enzopereira1701/wineguard/README.md

<p align="center">
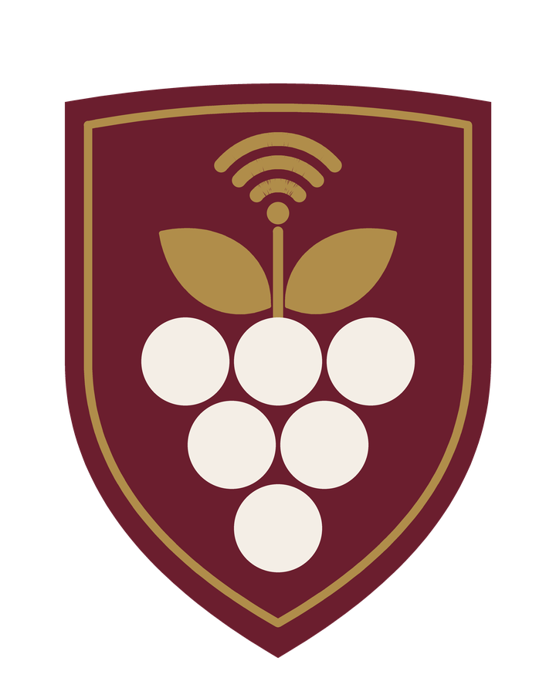
[picture p1: docs/imagens/wineguard-emblema.png]
Emblema do WineGuard
  
</p>

<h1 align="center">WineGuard</h1>
<p align="center"><em>Cada garrafa no ponto certo.</em></p>

Monitoramento de adegas de vinho com **IoT**: um dispositivo com ESP32 vigia temperatura, umidade e luminosidade, avisa na hora por **LED,
buzzer e tela** quando algo sai do ponto, e envia os dados para uma plataforma **FIWARE**. Um **dashboard web** mostra tudo em tempo real,
em gráficos, e deixa cadastrar dispositivos, ajustar os limites e gerenciar várias vinherias.

Projeto do grupo **marcha.dev** para o **CP5 Vinheria Full**. Base: *FIWARE Smart Lamp* e *FIWARE Descomplicado*, do Prof. Fábio H. Cabrini.

## Sumário

1\. [O problema](#o-problema) · 2. [A solução](#a-solução) · 3. [Diferenciais](#diferenciais) · 4. [Status do projeto](#status-do-projeto)  
5\. [Demonstração](#demonstração) · 6. [Arquitetura](#arquitetura) · 7. [Várias vinherias](#várias-vinherias)  
8\. [O Node (hardware)](#o-wineguard-node-hardware) · 9. [Alertas](#como-o-node-avisa) · 10. [Protocolo](#protocolo-mqtt)  
11\. [Plataforma FIWARE](#plataforma-fiware) · 12. [Dashboard](#dashboard) · 13. [Referências de guarda](#referências-de-guarda)  
14\. [Como rodar](#como-rodar) · 15. [Estrutura do repositório](#estrutura-do-repositório) · 16. [Limitações e evolução](#limitações-e-evolução)  
17\. [Créditos](#créditos) · 18. [Equipe](#equipe)  

## O problema

Vinho guardado em condições erradas estraga, e quase sempre ninguém percebe a tempo. Segundo especialistas e fabricantes de adegas:

- **Temperatura:** o calor acelera o envelhecimento. E o que mais prejudica não é só o valor, é a temperatura que sobe e desce.
- **Umidade:** muito baixa resseca as rolhas; muito alta danifica rótulos e caixas.
- **Luz:** luz forte altera a cor e o sabor, principalmente em espumantes e garrafas de vidro claro.

Uma adega comum não avisa ninguém quando isso acontece, e a pessoa só descobre quando o vinho já foi perdido.

## A solução

| Parte | O que é |
|---|---|
| **WineGuard Node** | ESP32 com sensores (DHT22 e LDR) e avisos (LED RGB, buzzer e tela OLED), numa caixa impressa em 3D. Um por adega |
| **Plataforma (FIWARE)** | Recebe as leituras por MQTT, guarda o último valor (Orion) e o histórico (STH-Comet) e leva os comandos de volta ao Node |
| **Backend (FastAPI)** | Confere os limites de cada adega, abre e fecha alertas, cuida de vinherias e da suspensão |
| **Dashboard (React)** | Gráficos em tempo real, cadastro de dispositivos, limites (triggers), histórico de alertas e vinherias |

Se a nuvem cair, o Node **continua alertando** sozinho, com os limites guardados na memória.

## Diferenciais

O que o WineGuard faz além de medir e mostrar (a lista completa, com onde ver e como provar cada ponto, está em [`docs/diferenciais.md`](docs/diferenciais.md)):

1. **Alerta em três canais, com significado:** a cor do LED diz a variável, o som diz o sentido (acima ou abaixo) e a tela mostra o valor e o limite.
2. **Continua protegendo sem a nuvem:** depois de 15 s sem conexão, o Node avalia os limites sozinho.
3. **Várias vinherias isoladas, com suspensão por inadimplência:** os dados não se misturam e o histórico é preservado.
4. **Referências de guarda com fontes e avisos:** presets de guarda (não de servir) e um painel que avisa quando os valores não fazem sentido.
5. **Alerta de estabilidade:** avisa quando a temperatura varia mais de 2 °C em 24 h, mesmo dentro da faixa.

De apoio: ajuste remoto dos limites com confirmação do Node, calibração da luz, cadastro e identificação de Nodes pelo painel, backend em contêiner que volta sozinho com 176 testes, Node físico em caixa 3D testado na nuvem e documentação completa, com as limitações assumidas.

## Status do projeto

Atualizado em 27/10/2026. Este README descreve o que existe e foi testado; o que falta está marcado.

| Parte | Estado |
|---|---|
| Node: hardware, firmware 2.3 e caixa impressa em 3D | **Pronto e testado** na bancada, na nuvem e no Wokwi |
| Plataforma FIWARE na AWS | **Pronta**: dados e histórico chegam, comandos chegam ao Node |
| Cadastro de dispositivo (`provisionar.sh` e pelo dashboard) | **Pronto** |
| Backend (FastAPI) | **Pronto**, rodando em contêiner na instância (porta 8000), com 176 testes automáticos |
| Dashboard (front-end) | **Pronto**, ligado ao backend real e testado no computador e no celular |
| Manuais de instalação e de operação | **Prontos** ([instalação](docs/manual-instalacao.md) e [operação](docs/manual-operacao.md)) |
| Vídeo | **A fazer** |

Provado de ponta a ponta com o Node físico: telemetria, histórico, alertas ALTA e BAIXA, mute (botão e dashboard), troca de limites
com confirmação do Node, "Identificar Node", queda e retorno da conexão e suspensão de vinheria.

## Demonstração

- **Simulação no Wokwi:** https://wokwi.com/projects/476972184977904641
- **Dashboard:** não é publicado. Roda no computador do grupo (`npm run dev`) e é aberto na apresentação, ligado ao backend na nuvem.
- **Vídeo:** https://youtu.be/-WqCwfTrkNc
- **Diferenciais:** [`docs/diferenciais.md`](docs/diferenciais.md)

<p align="center">
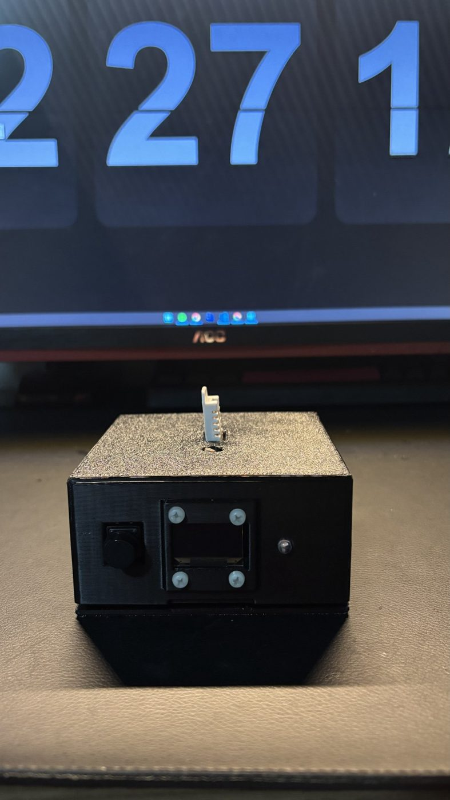
[picture p2: hardware/fotos/node/montado-frente.jpg]
WineGuard Node montado na caixa
  
  &nbsp;
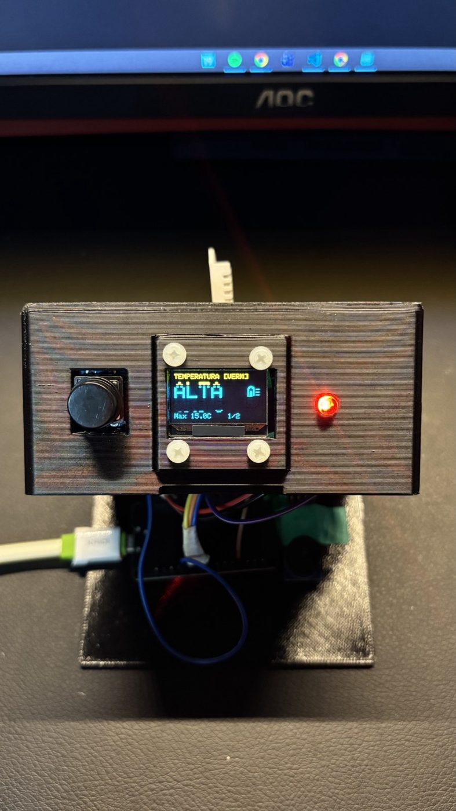
[picture p3: hardware/fotos/node/alerta-temperatura-alta.jpg]
Alerta de temperatura alta: LED vermelho e tela
  
</p>
<p align="center"><em>O Node montado na caixa em 3D e um alerta de temperatura ALTA (LED vermelho fixo e tela). Mais fotos em <a href="hardware/fotos/README.md"><code>hardware/fotos/</code></a>.</em></p>

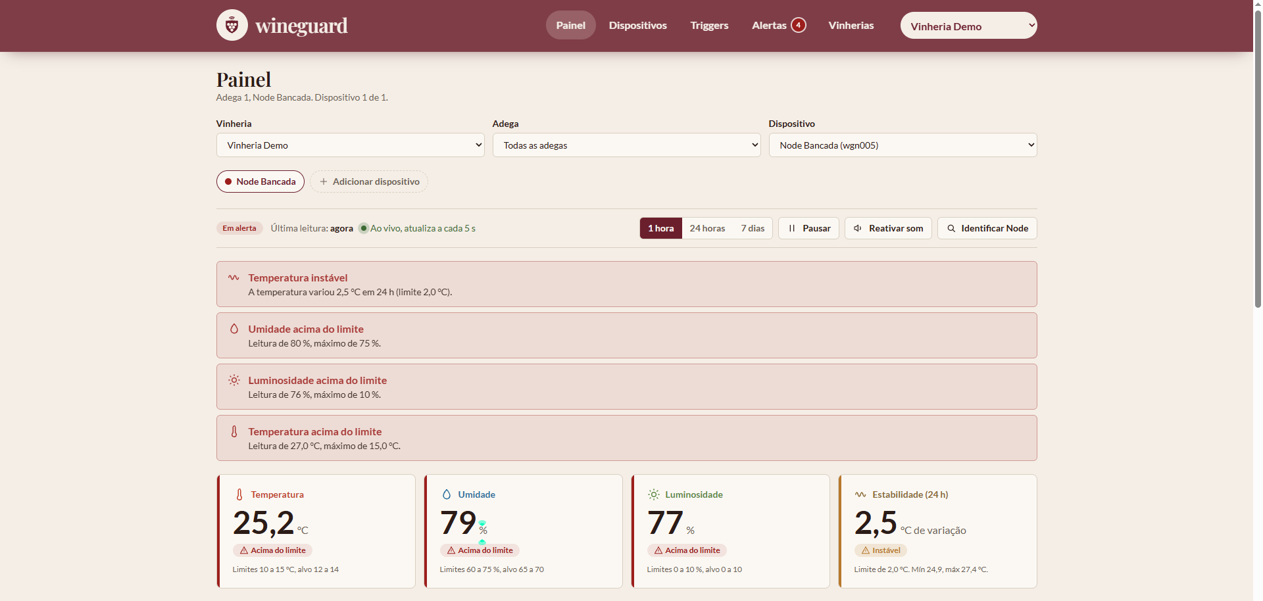
[picture p4: docs/prints/painel-em-alerta_1.png]
Painel do dashboard com um alerta ativo


## Arquitetura

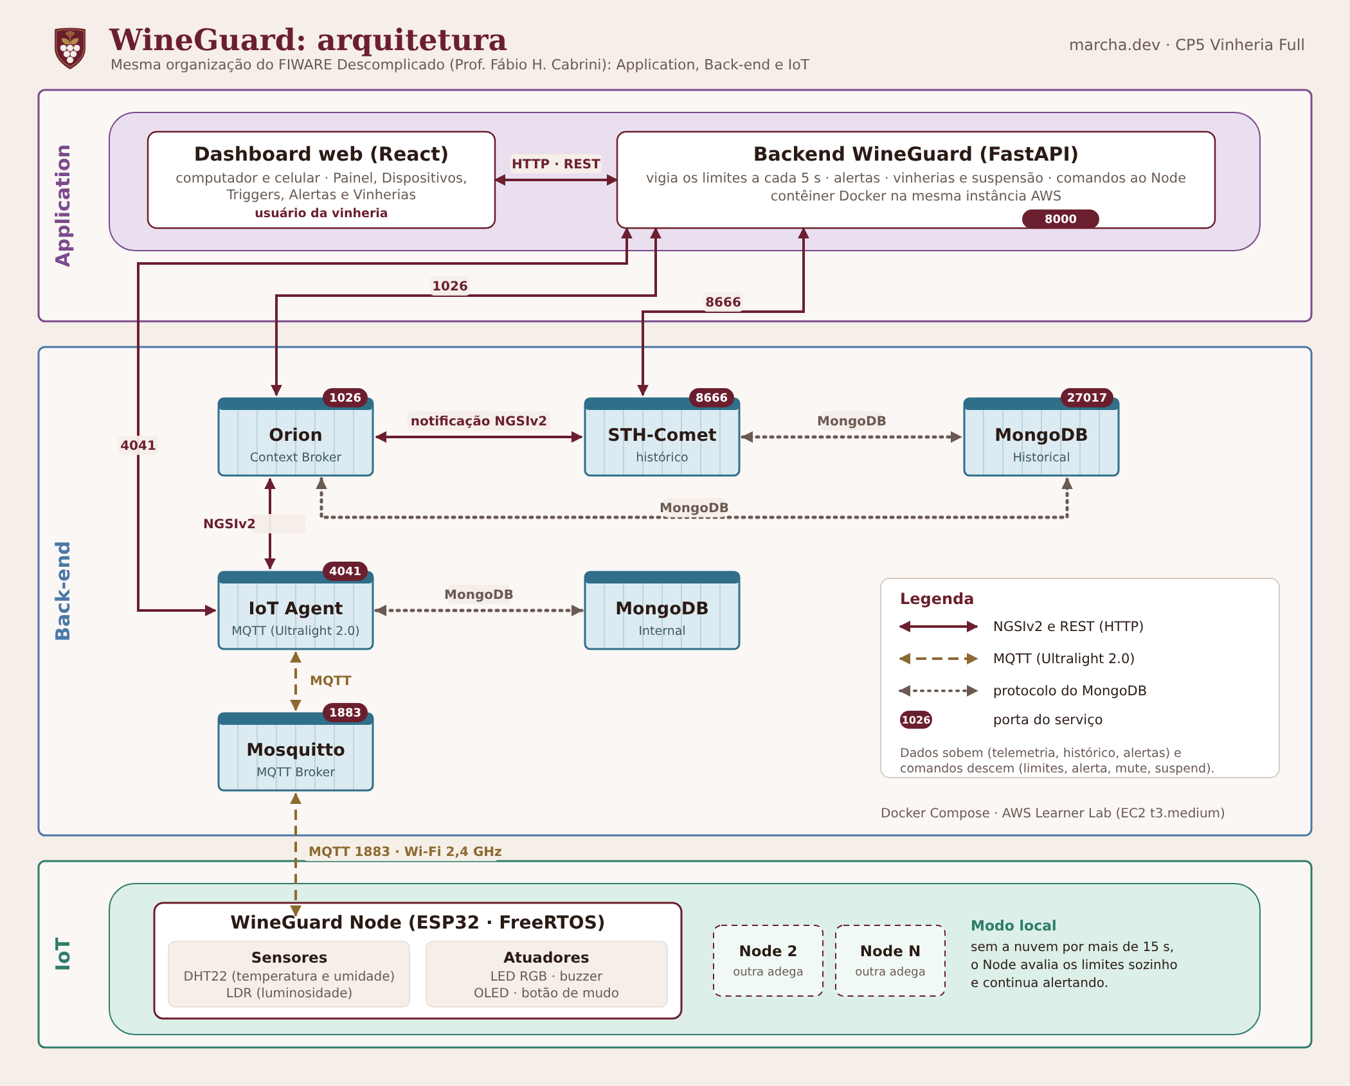
[picture p5: docs/arquitetura.png]
Arquitetura do WineGuard em três blocos: Application, Back-end e IoT


O desenho segue a mesma organização do *FIWARE Descomplicado* (Prof. Fábio H. Cabrini): três blocos, com os contêineres, as portas e os protocolos.

| Bloco | O que tem | Como se comunica |
|---|---|---|
| **Application** | Dashboard (React) e backend WineGuard (FastAPI, em contêiner, porta 8000) | O dashboard fala com o backend por HTTP/REST. O backend consulta o Orion (1026), o IoT Agent (4041) e o STH-Comet (8666) por NGSIv2/REST |
| **Back-end** | Orion, STH-Comet, IoT Agent MQTT, Mosquitto (1883) e dois MongoDB, em contêineres Docker Compose na AWS | O IoT Agent traduz MQTT (Ultralight 2.0) para NGSIv2 e atualiza o Orion; o Orion avisa o STH-Comet, que guarda o histórico; os dados ficam no MongoDB |
| **IoT** | WineGuard Node (ESP32 com DHT22, LDR, LED RGB, buzzer, OLED e botão de mudo); um por adega | MQTT pelo Wi-Fi 2,4 GHz, até o Mosquitto (porta 1883) |

Os dados **sobem** (telemetria, histórico, alertas) e os comandos **descem** (limites, alerta, mute, suspend) pelo mesmo caminho. Como a ferramenta do professor, é uma prova de conceito: não inclui login nem criptografia (veja [Limitações e evolução](#limitações-e-evolução)).

Nosso modelo de cinco camadas continua valendo, e cabe nos três blocos:

| Camada | Bloco | Tecnologia |
|---|---|---|
| 1. Percepção (sensores e atuadores) | IoT | ESP32, Arduino (FreeRTOS), DHT22, LDR, LED RGB, buzzer, OLED |
| 2. Comunicação | IoT e Back-end | Wi-Fi 2,4 GHz, MQTT, Mosquitto, Ultralight 2.0 |
| 3. Plataforma | Back-end | FIWARE (IoT Agent, Orion, STH-Comet, MongoDB), Docker, AWS |
| 4. Aplicação (regras de negócio) | Application | FastAPI (Python), em contêiner Docker |
| 5. Apresentação | Application | React, Vite, Tailwind, Recharts |

## Várias vinherias

A plataforma separa os dados de cada cliente com o recurso de *multi-tenancy* do FIWARE:

| Conceito | No FIWARE |
|---|---|
| Vinheria | `fiware-service` (ex.: `vin_demo`) |
| Adega | `fiware-servicepath` (ex.: `/adega1`) |
| Node | `device_id` (ex.: `wgn001`) e `apikey` da vinheria |
| Entidade no Orion | `urn:ngsi-ld:WineGuardNode:001` |

Cada vinheria tem **nome, vencimento e status** (ativa ou suspensa). Ao suspender, os Nodes apagam LED e buzzer, param de enviar
dados e o painel mostra o aviso de serviço suspenso. O histórico é preservado.

## O WineGuard Node (hardware)

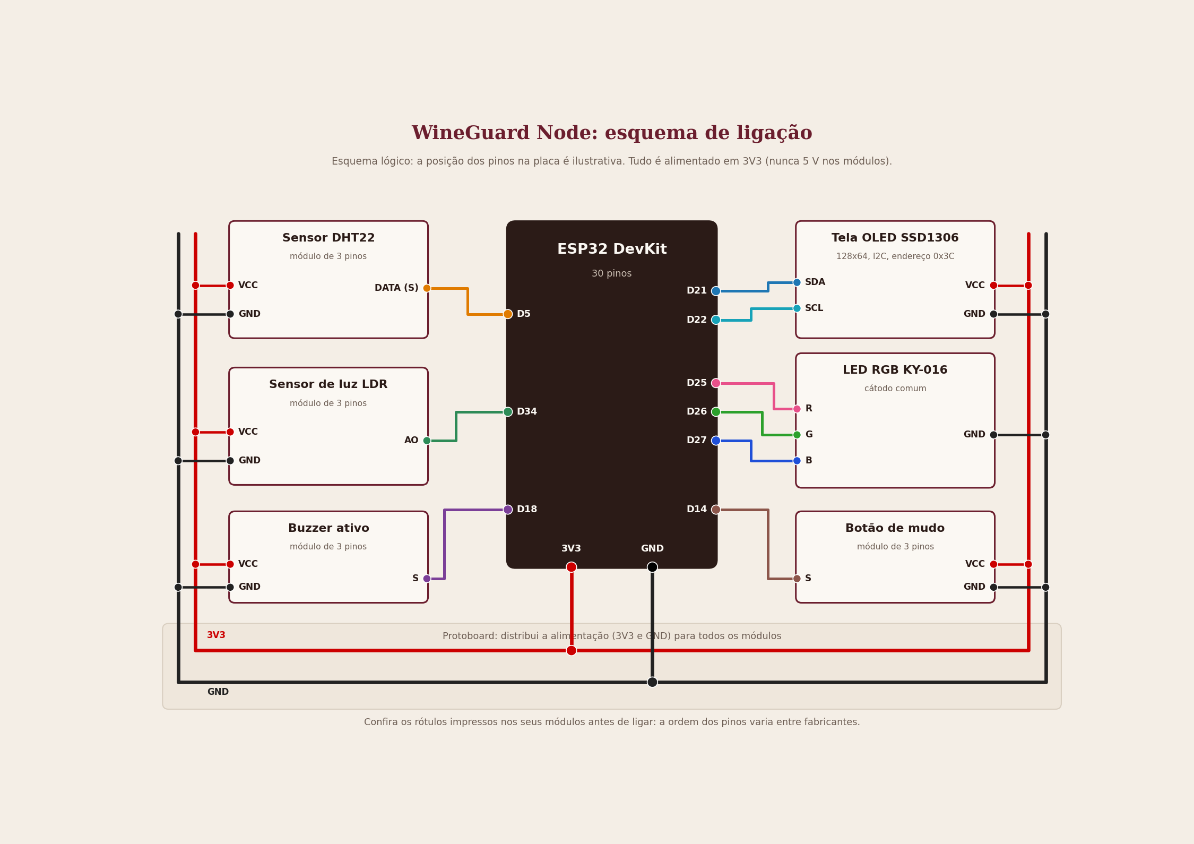
[picture p6: hardware/esquema-ligacao.png]
Esquema de ligação


| Componente | Função | Pino do ESP32 |
|---|---|---|
| DHT22 (módulo de 3 pinos) | Temperatura e umidade | D5 |
| LDR (módulo de 3 pinos) | Luminosidade (em % relativa) | D34 |
| Buzzer ativo (módulo de 3 pinos) | Alerta sonoro | D18 |
| LED RGB KY-016 | Alerta visual: vermelho, verde e azul | D25, D26, D27 |
| OLED SSD1306 128x64 (I2C) | Valores, alertas e estado | D21 (SDA), D22 (SCL) |
| Botão de mudo (módulo de 3 pinos) | Silencia o buzzer | D14 |

Montagem sem solda, com um protoboard como distribuidor de 3V3 e GND e a caixa impressa em 3D (PLA, tampa removível por parafusos).
Detalhes em [`hardware/esquema-ligacao.md`](hardware/esquema-ligacao.md) e [`hardware/lista-de-materiais.md`](hardware/lista-de-materiais.md).

## Como o Node avisa

A **cor do LED** e a **tela** dizem qual variável. O **LED** e o **som** dizem o sentido:

| | LED | Buzzer | Tela |
|---|---|---|---|
| **ALTA** (acima do limite) | Fixo na cor da variável | 1 bipe longo repetido | "ALTA", valor e limite máximo |
| **BAIXA** (abaixo do limite) | Pisca junto com o som | 2 bipes e uma pausa | "BAIXA", valor e limite mínimo |

Cores: **vermelho** = temperatura, **azul** = umidade, **verde** = luminosidade (as mesmas dos gráficos do dashboard).
Com mais de uma variável em alerta, o Node alterna entre elas, com uma pausa de silêncio. O botão silencia só o buzzer; o LED continua.
Se o Node perder a conexão por mais de 15 s, avalia os limites sozinho. Detalhes do firmware em [`hardware/firmware/README.md`](hardware/firmware/README.md).

## Protocolo (MQTT)

Ultralight 2.0 sobre MQTT, no padrão do *FIWARE Descomplicado*:

| Tópico | Sentido | Conteúdo |
|---|---|---|
| `/<API_KEY>/<DEVICE_ID>/attrs` | Node para a nuvem | Telemetria |
| `/<API_KEY>/<DEVICE_ID>/cmd` | Nuvem para o Node | Comandos |
| `/<API_KEY>/<DEVICE_ID>/cmdexe` | Node para a nuvem | Resposta do comando |

```
Telemetria  t|24.5|h|60.0|l|35|st|ok|mu|0|rs|-60|fw|2.3
            temperatura, umidade, luz (%), estado, mudo, sinal Wi-Fi, versão do firmware

Comandos    <DEVICE_ID>@<comando>|<parametros>
            setTriggers|tmin,tmax,hmin,hmax,lmin,lmax     alert|<t|h|l>,<high|low>,<1|0>
            mute|<1|0>   suspend|   resume|   setInterval|<segundos>   identify|
```

No Orion, os atributos viram `temperature`, `humidity`, `luminosity`, `state`, `muted`, `rssi` e `firmware`.

## Plataforma FIWARE

Roda em Docker numa instância da AWS (Learner Lab) e usa a base do professor: Mosquitto, IoT Agent (Ultralight), Orion, STH-Comet e dois MongoDB.
O **backend** entra como mais um contêiner (`wineguard-backend`, porta 8000) no mesmo Compose, por um arquivo de override (veja [Como rodar](#6-na-instância-aws-backend-em-contêiner)).
O backend fala com Orion, STH-Comet e IoT Agent por dentro do Docker; por isso só ficam abertas ao mundo as portas **22** (SSH), **1883** (o Node) e **8000** (a API).

O script [`fiware/scripts/provisionar.sh`](fiware/scripts/provisionar.sh) cadastra uma vinheria (*service*), o dispositivo e a assinatura que
manda o histórico para o STH-Comet. No dia a dia o cadastro é feito pelo dashboard, que chama o backend.

> **Lição aprendida:** o dispositivo precisa ser cadastrado **com a `apikey`**. Sem ela, o IoT Agent não reconhece o cadastro, cria um
> dispositivo novo sozinho (sem o mapeamento `t` para `temperature`) e as leituras vão para a entidade errada. O script e o backend já fazem certo.

> **Lição aprendida:** depois de reiniciar o Mosquitto, é preciso reiniciar também o IoT Agent; sem isso o Node reconecta, mas os dados não chegam ao Orion.

## Dashboard

Front-end em React (Vite, React Router, Tailwind e Recharts), para computador e celular.

| Tela | O que faz |
|---|---|
| Início | O problema, a solução e a equipe |
| Painel | Um dispositivo por vez, com os outros em chips. Valores de agora, 4 gráficos (temperatura, umidade, luz e combinado), estabilidade de 24 h, atualização a cada 5 s. Silenciar o buzzer e "Identificar Node" |
| Dispositivos | Cadastrar, editar e remover; mostra o bloco de configuração (`config.h`) do Node |
| Triggers | Limites por preset de guarda ou personalizados, avisos quando fogem da referência, calibração da luz. Ao salvar, o limite vai ao Node e o painel mostra quando ele confirmou |
| Alertas | Histórico com início, fim e duração, e filtros |
| Vinherias | Cadastro, vencimento, suspender e reativar |
| Suspenso | Aviso quando a vinheria está suspensa |

| Painel | Triggers |
|---|---|
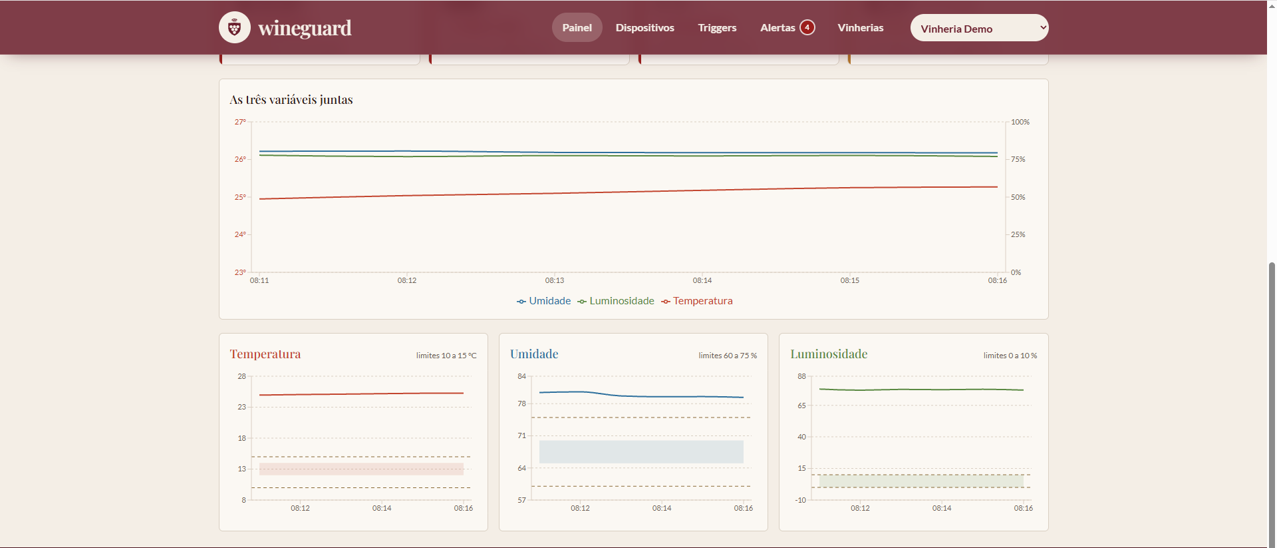
[picture p7: docs/prints/painel-em-alerta_2.png]
Painel
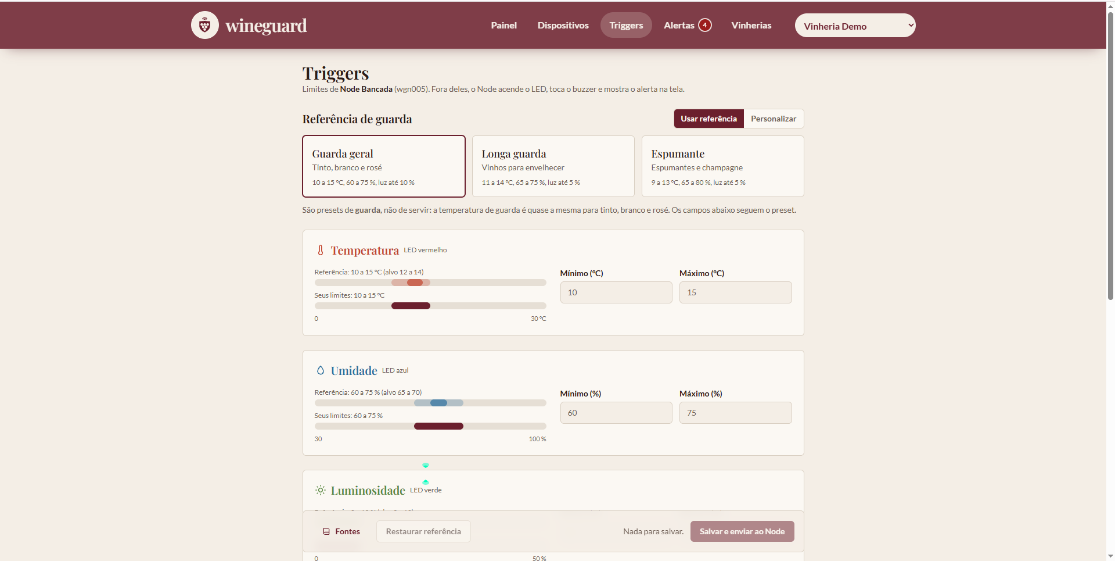
[picture p8: docs/prints/triggers_1.png]
Triggers
|  |  |

| Alertas | Dispositivos | Vinherias |
|---|---|---|
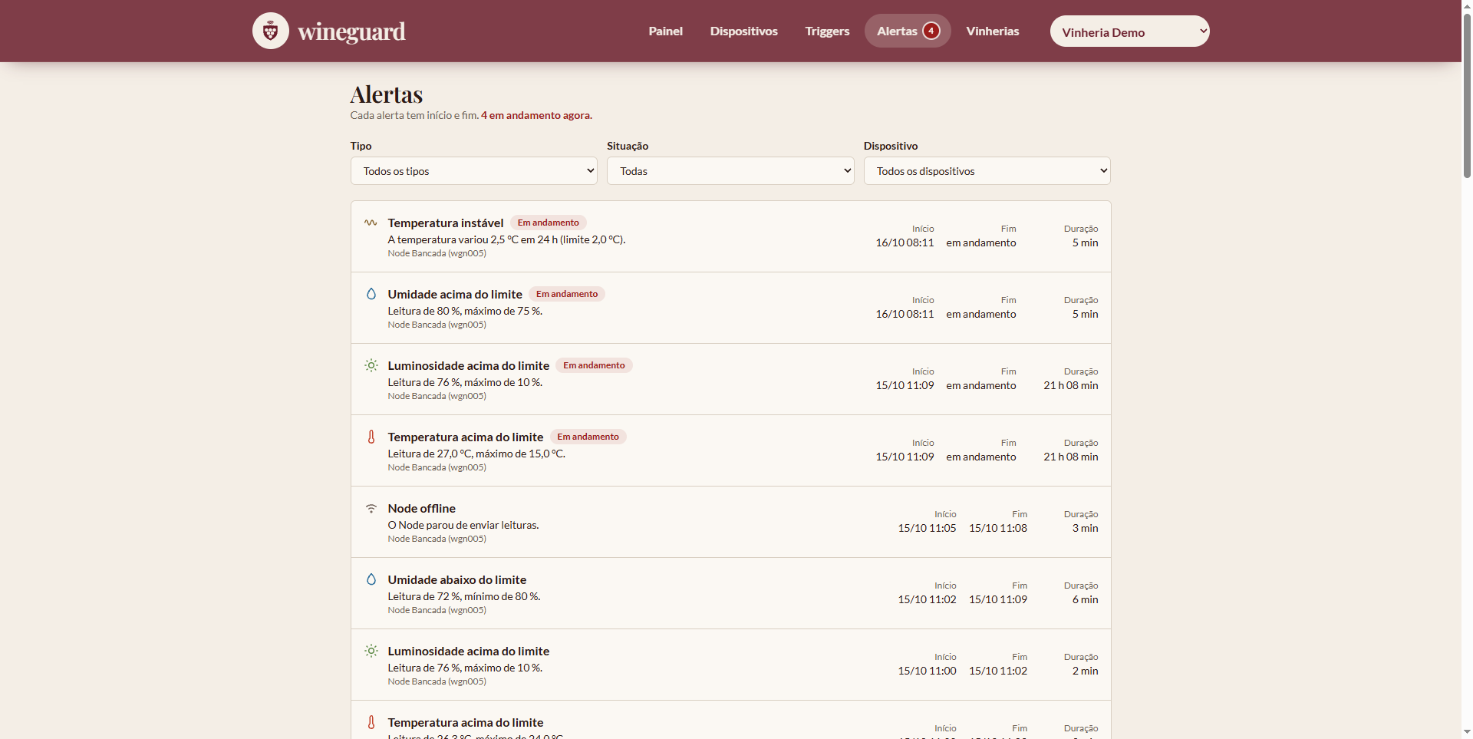
[picture p9: docs/prints/alertas.png]
Alertas
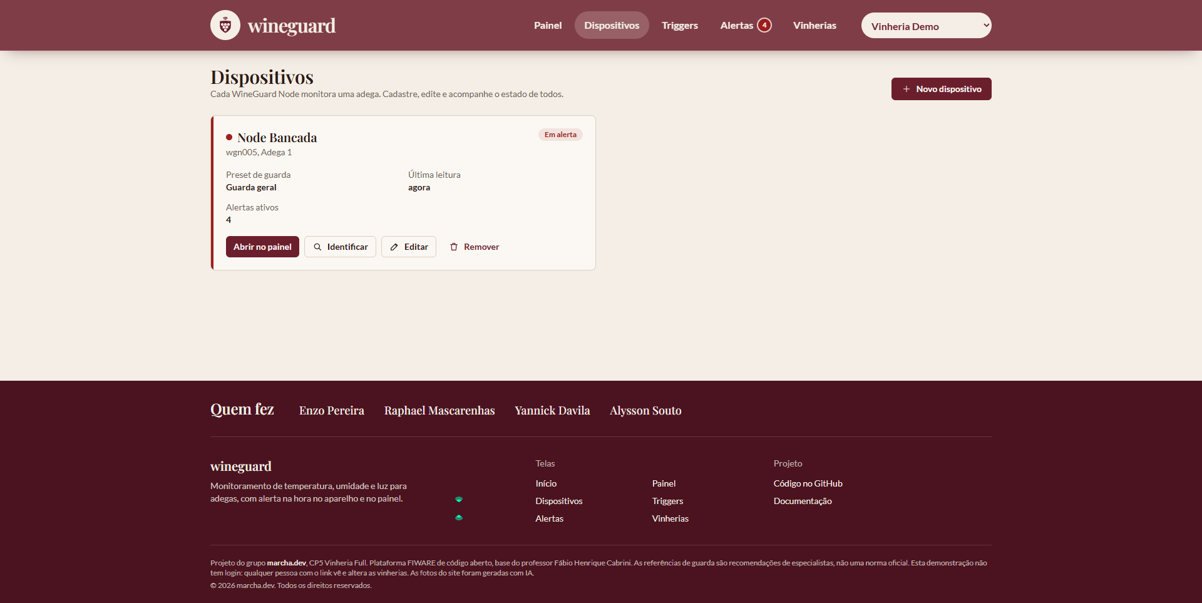
[picture p10: docs/prints/dispositivos.png]
Dispositivos
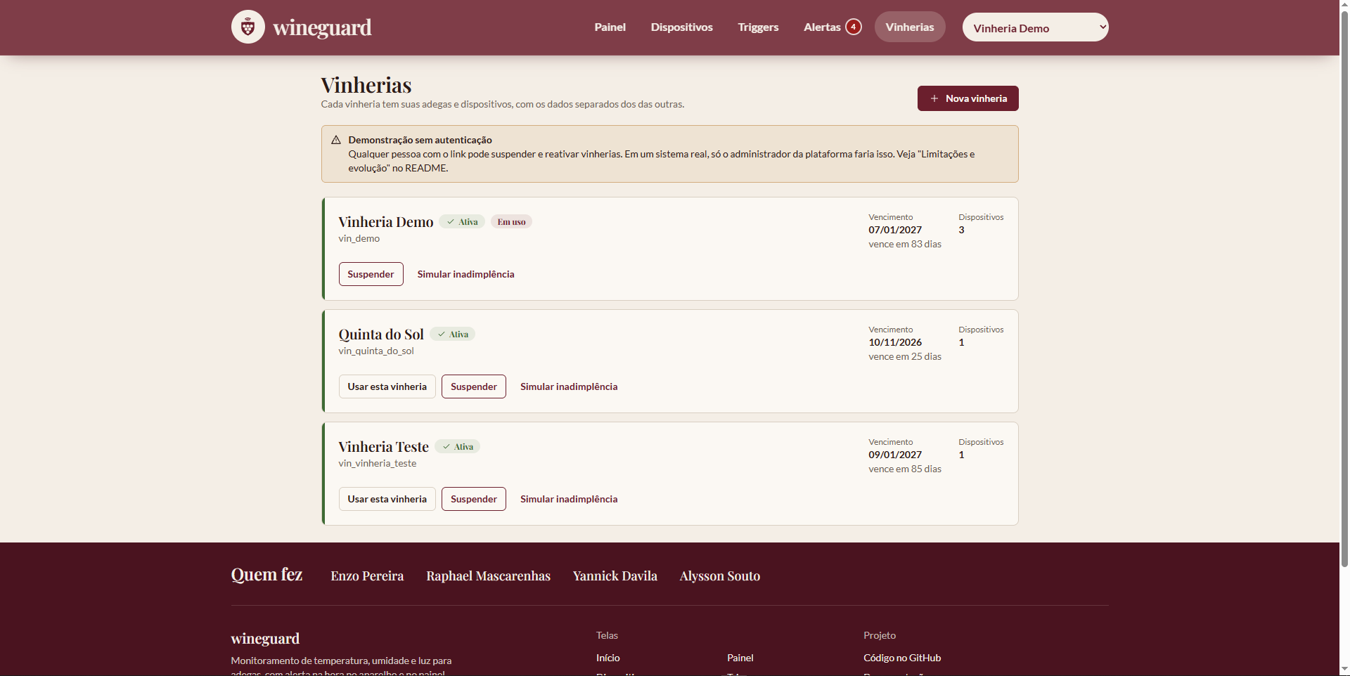
[picture p11: docs/prints/vinherias.png]
Vinherias
|  |  |  |

Toda comunicação passa por uma camada única (`frontend/src/services/api.js`). O formato dos dados entre o dashboard e o backend está definido em
[`docs/api-contrato.md`](docs/api-contrato.md). Para desenvolver sem backend, `VITE_USE_MOCK=true` liga **dados de demonstração** gerados no navegador.

## Referências de guarda

Os limites vêm de recomendações de especialistas e de fabricantes de adegas (Decanter, Jancis Robinson, EuroCave, Nicolas Feuillatte e
Forbes Brasil). **Não são uma norma oficial**: os limites de alerta são uma adaptação do grupo.

| Preset | Temperatura | Umidade | Luz máx. |
|---|---|---|---|
| Guarda geral (tinto, branco e rosé) | 10 a 15 °C | 60 a 75 % | 10 % |
| Longa guarda | 11 a 14 °C | 65 a 75 % | 5 % |
| Espumante | 9 a 13 °C | 65 a 80 % | 5 % |

São presets de **guarda**, não de servir. Fontes e detalhes em [`docs/referencias.md`](docs/referencias.md).

## Como rodar

### 1. Ver a simulação (Wokwi)

Abra https://wokwi.com/projects/476972184977904641 e clique em Play. Mexa no controle de lux do LDR e na temperatura e umidade do DHT22
para disparar os alertas. Detalhes em [`simulacao/wokwi.md`](simulacao/wokwi.md).

### 2. Montar e gravar o Node

1. Monte o circuito pelo [`esquema de ligação`](hardware/esquema-ligacao.md).
2. Instale a Arduino IDE, o pacote **esp32** e as bibliotecas (lista em [`hardware/firmware/README.md`](hardware/firmware/README.md)).
3. Em `hardware/firmware/wineguard_node/`, copie `config.example.h` para `config.h` e preencha (`SIMULACAO_WOKWI 0` na bancada).
4. Grave na placa **ESP32 Dev Module** e abra o monitor serial a 115200.

Sem a nuvem, o Node funciona sozinho: lê os sensores e avisa com os limites do preset Guarda geral.

### 3. Plataforma FIWARE

Com a base FIWARE do professor rodando na máquina (Mosquitto, IoT Agent, Orion e STH-Comet), dentro dela:

```bash
bash fiware/scripts/provisionar.sh vin_demo /adega1 winedemo 005
```

Conferir se os dados chegam (troque `localhost` pelo endereço da máquina, se for de fora):

```bash
curl -s "http://localhost:1026/v2/entities/urn:ngsi-ld:WineGuardNode:005?type=WineGuardNode" \
  -H "fiware-service: vin_demo" -H "fiware-servicepath: /adega1"
```

No `config.h` do Node, use a mesma `API_KEY` (`winedemo`) e o `DEVICE_ID` (`wgn005`), e em `MQTT_BROKER` o endereço da máquina.
O IP da instância do Learner Lab **muda a cada sessão**: troque o `MQTT_BROKER` e grave o Node de novo.

### 4. Backend (no seu computador)

Na pasta `backend`, no Git Bash (Windows):

```bash
py -m venv .venv                      # cria o ambiente virtual (uma vez)
source .venv/Scripts/activate         # ativa (aparece "(.venv)" no começo da linha)
pip install -r requirements.txt       # instala as bibliotecas (uma vez)
cp .env.example .env                  # e edite o .env (FIWARE_HOST = IP da instância)
uvicorn app.main:app --reload         # sobe a API em http://127.0.0.1:8000
```

Documentação interativa em <http://127.0.0.1:8000/docs>. Testes: `python -m unittest discover -s tests -v`. Detalhes das rotas em [`backend/README.md`](backend/README.md).
Rode **um backend só** por vez (dois vigias duplicam os alertas): se o contêiner da instância estiver no ar, não suba outro no computador.

### 5. Dashboard

```bash
cd frontend
npm install
cp .env.example .env      # no Windows: copie o arquivo e renomeie para .env
npm run dev
```

No `.env`, `VITE_API_URL` é o endereço do backend (`http://localhost:8000` ou `http://<IP da instância>:8000`) e `VITE_MQTT_HOST` é o IP da instância
(aparece no bloco de configuração do Node). Abra o endereço que o terminal mostrar (normalmente http://localhost:5173). Para abrir no celular, no mesmo
Wi-Fi: `npm run dev -- --host` e use o endereço `Network:`.

### 6. Na instância (AWS): backend em contêiner

1. Base FIWARE do professor em `~/fiware` (`sudo docker compose up -d`).
2. `git clone` deste repositório em `~/wineguard` e crie `~/wineguard/backend/.env` (modelo em `backend/.env.example`), com `FIWARE_HOST=host.docker.internal`.
3. Copie o serviço do backend e suba:

```bash
cp ~/wineguard/fiware/docker-compose.backend.yml ~/fiware/docker-compose.override.yml
cd ~/fiware && sudo docker compose up -d --build wineguard-backend
```

4. No Security Group da instância, deixe abertas só as portas **22**, **1883** e **8000**.
5. Teste do seu computador: `curl http://<IP da instância>:8000/api/vinherias`.

O contêiner tem `restart: unless-stopped`: depois de um novo *Start Lab* ele volta sozinho. Para atualizar o código: `git pull` em `~/wineguard` e repita o `up -d --build`.

## Estrutura do repositório

```
wineguard/
├── README.md
├── backend/                    API FastAPI (app/, tests/, Dockerfile, requirements.txt, .env.example)
├── docs/
│   ├── arquitetura.png         diagrama de arquitetura (Application, Back-end e IoT)
│   ├── decisoes.md             decisões e aprendizados do projeto
│   ├── referencias.md          referências de guarda
│   ├── api-contrato.md         formato dos dados entre dashboard e backend
│   ├── diferenciais.md         o que o WineGuard faz além do básico, com como provar
│   ├── manual-instalacao.md    montar e instalar do zero
│   ├── manual-operacao.md      usar e manter o sistema
│   ├── roteiro-video.md        roteiro do vídeo
│   ├── roteiro-handson.md      roteiro do hands-on
│   ├── prints/                 telas do dashboard
│   └── imagens/                emblema e imagens do README
├── fiware/
│   ├── scripts/provisionar.sh
│   └── docker-compose.backend.yml   serviço do backend (override do compose do FIWARE)
├── frontend/                   dashboard React (Vite)
├── hardware/
│   ├── esquema-ligacao.md, esquema-ligacao.png
│   ├── lista-de-materiais.md
│   ├── fotos/                  Node montado, componentes e caixa
│   └── firmware/wineguard_node/   .ino, icones.h e config.example.h
├── simulacao/                  Wokwi (diagram.json, libraries.txt, wokwi.md)
└── video/link.md
```

## Limitações e evolução

Limitações conhecidas desta versão (é uma prova de conceito):

- **Sem autenticação.** Qualquer pessoa com o link vê e altera qualquer vinheria. A suspensão por inadimplência é uma demonstração.
- O *multi-tenant* organiza os dados, mas **não os protege** entre vinherias.
- **MQTT sem usuário, senha e TLS**; a pilha FIWARE também roda sem TLS e sem autenticação. Quem souber a `apikey` consegue publicar.
- O sensor de luz mede em **% relativa**, não em lux, e o valor varia de um módulo para outro (por isso há a calibração).
- O DHT22 tem margem de **±0,5 °C**.
- O **buzzer diferencia o sentido** (alta ou baixa), mas **não a variável**: ela é identificada pela cor do LED e pela tela. Quem não enxerga o LED nem
  a tela não distingue a variável pelo som.
- O IoT Agent **recria** dispositivos apagados enquanto o ESP32 continuar publicando.
- O IP da máquina do Learner Lab muda a cada sessão; ele é trocado à mão no `config.h` do Node e no `.env` do dashboard.
- A API aceita chamadas de **qualquer origem** (CORS liberado) e o dashboard não é publicado: é uma demonstração, sem login.
- As referências de guarda são recomendações, não uma norma.

Evolução prevista: login por usuário e perfis, banco relacional, MQTT com TLS, cancelamento de vinheria com carência, exportação em CSV,
WiFiManager (configurar o Wi-Fi sem regravar), um buzzer passivo para diferenciar a variável pelo tom e alertas externos.

## Créditos

- **FIWARE Descomplicado** e **FIWARE Smart Lamp**: base da plataforma e do protocolo, do Prof. Fábio H. Cabrini.
- Emblema do WineGuard: imagem de referência gerada com apoio de IA e **redesenhada em SVG** pelo grupo.
- Este projeto foi desenvolvido com apoio de assistentes de IA (Claude, da Anthropic) em planejamento, código e documentação.
  O grupo testou o que está descrito como "pronto".
- Fontes das referências de guarda em [`docs/referencias.md`](docs/referencias.md).
- Fotos do site (adega, termômetro, rolha, garrafa com luz e vinhedo): **geradas com IA** (ChatGPT) a partir de prompts escritos pelo grupo. Não são fotos reais.
- Fotos do Node, dos componentes e da caixa em `hardware/fotos/`: **reais**, tiradas pelo grupo.
- Ícones do site: desenhados pelo grupo em SVG, no mesmo traço.

## Equipe

**marcha.dev**

- Enzo Pereira
- Raphael Mascarenhas
- Yannick Davila
- Alysson Souto
