enzopereira1701/wineguard/hardware/fotos/README.md

# Fotos do WineGuard Node

Fotos tiradas em 15/10/2026, reduzidas para uso no README, no manual e no pitch (sem GPS nem outros metadados).

## node/ (o Node montado)

| Arquivo | O que mostra |
|---|---|
| `montado-frente.jpg` | Frente da caixa fechada: botão de mute, tela OLED e LED. O DHT22 sai pelo topo. |
| `montado-frente-fiacao.jpg` | Frente do Node na base, com a fiação por baixo e o cabo USB. |
| `montado-lateral.jpg` | Lateral com as aberturas de ventilação e o DHT22 para fora. |
| `montado-diagonal.jpg` | A outra lateral, em ângulo. |
| `montado-traseira.jpg` | Traseira, com a janela do LDR e a chave. |
| `alerta-temperatura-alta.jpg` | Alerta de temperatura ALTA: LED vermelho e tela mostrando "ALTA" e o limite máximo. **Boa foto para o README.** |
| `alerta-led-vermelho.jpg` | O mesmo alerta, com o LED vermelho aceso, no escuro. |
| `alerta-luz-alta.jpg` | Alerta de luminosidade ALTA: LED verde e tela com o valor. |
| `alerta-luz-oled.jpg` | Alerta de luz, tela em destaque. |
| `alerta-luz-escuro.jpg` | Alerta de luz, vista geral no escuro. |

## componentes/

ESP32 DevKit, LED RGB, buzzer, sensor de luz (LDR), DHT22, display OLED e protoboard.

## caixa/

Peças da caixa impressa em 3D: tampa e base (vistas de cima e em ângulo).
