enzopereira1701/wineguard/video/link.md

# Vídeo de demonstração

**link**  https://youtu.be/-WqCwfTrkNc
