enzopereira1701/wineguard/docs/imagens/previa-emblema.png

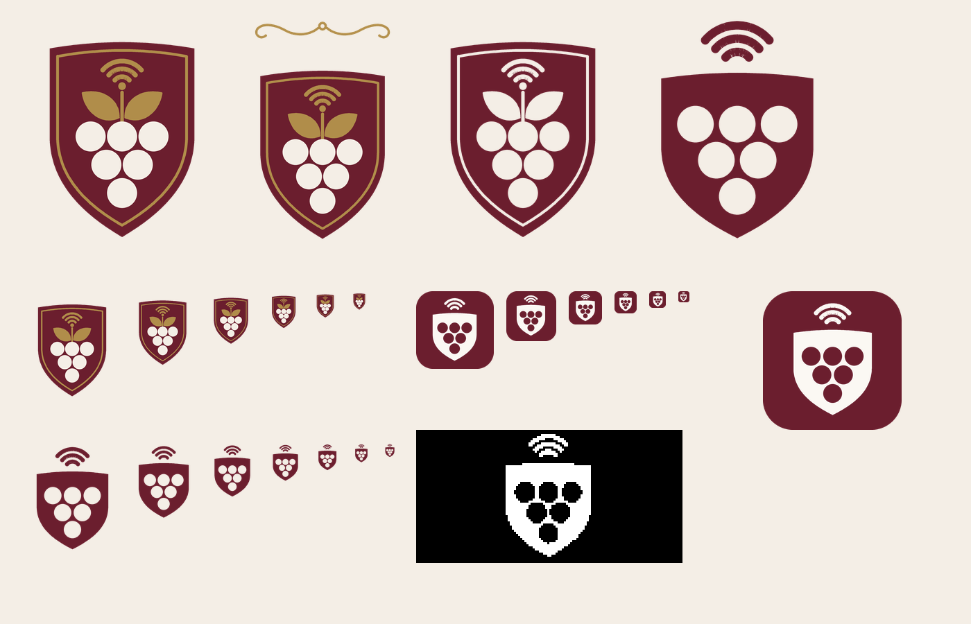
docs/imagens/previa-emblema.png
