enzopereira1701/wineguard/frontend/src/assets/img/ameaca-luz.webp

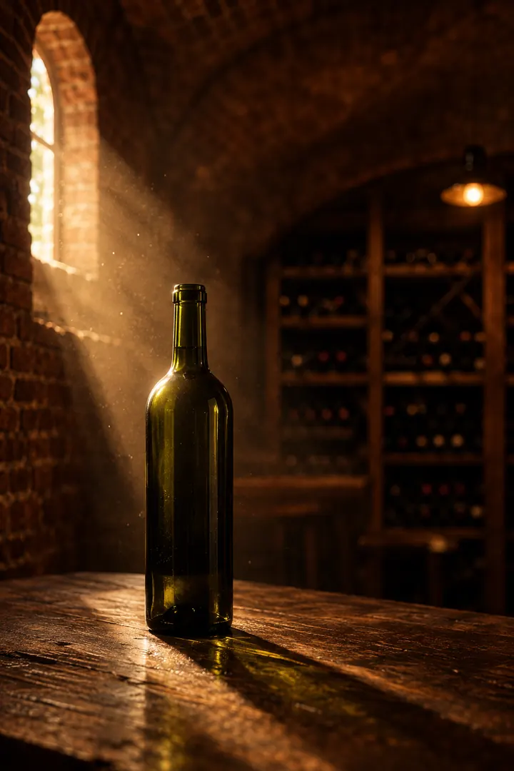
frontend/src/assets/img/ameaca-luz.webp
