enzopereira1701/wineguard/frontend/src/assets/img/ameaca-temperatura.webp

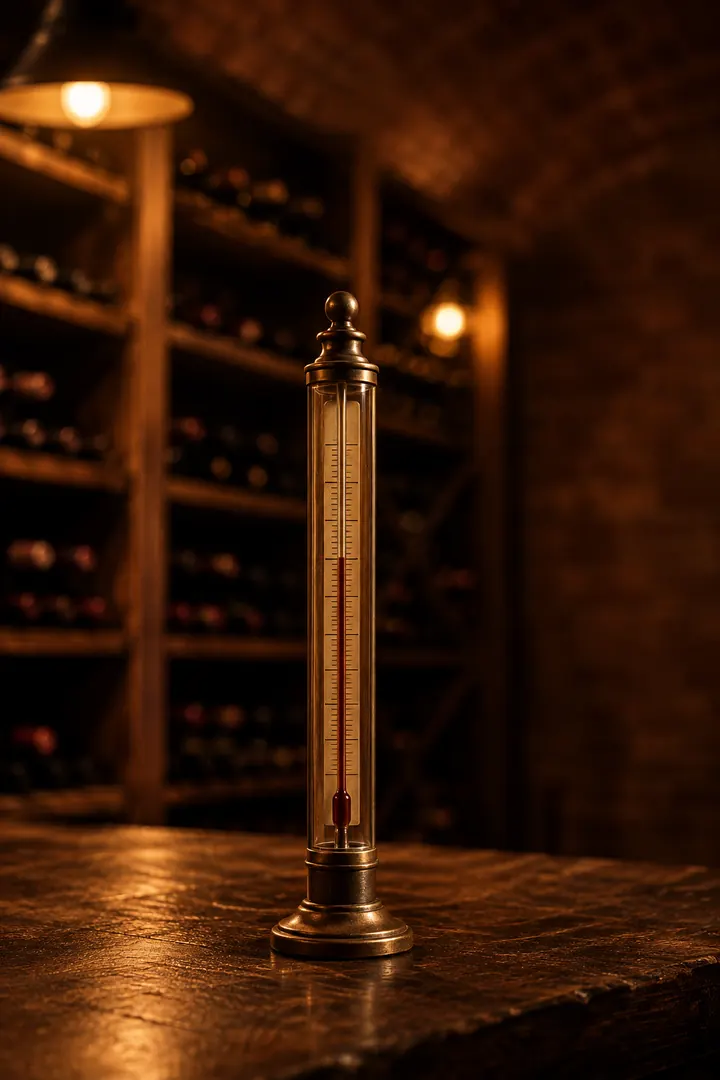
frontend/src/assets/img/ameaca-temperatura.webp
