enzopereira1701/wineguard/frontend/src/assets/img/ameaca-umidade.webp

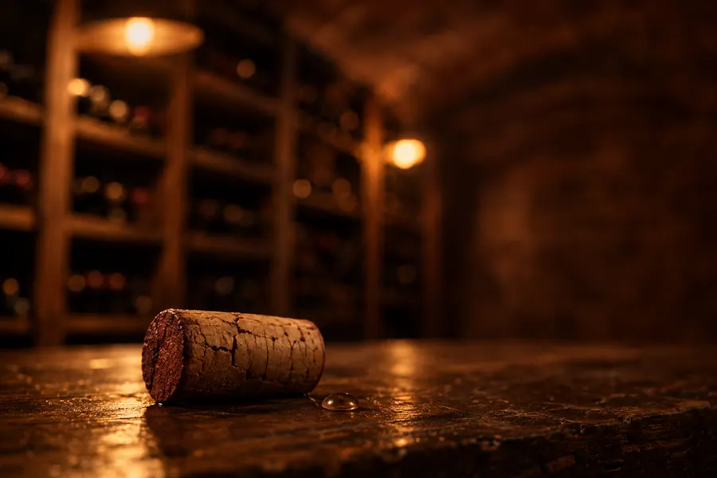
frontend/src/assets/img/ameaca-umidade.webp
