enzopereira1701/wineguard/frontend/src/assets/img/hero-adega.webp

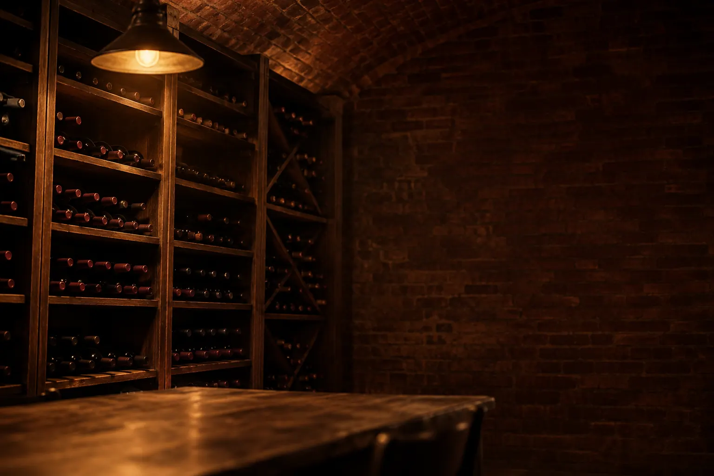
frontend/src/assets/img/hero-adega.webp
