enzopereira1701/wineguard/hardware/fotos/caixa/base-vista-de-cima.jpg

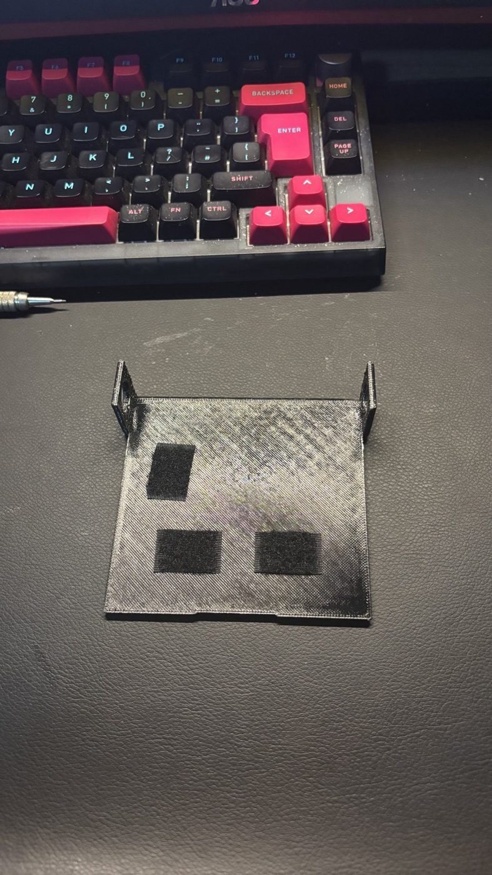
hardware/fotos/caixa/base-vista-de-cima.jpg
