enzopereira1701/wineguard/hardware/fotos/caixa/base-vista-em-angulo.jpg

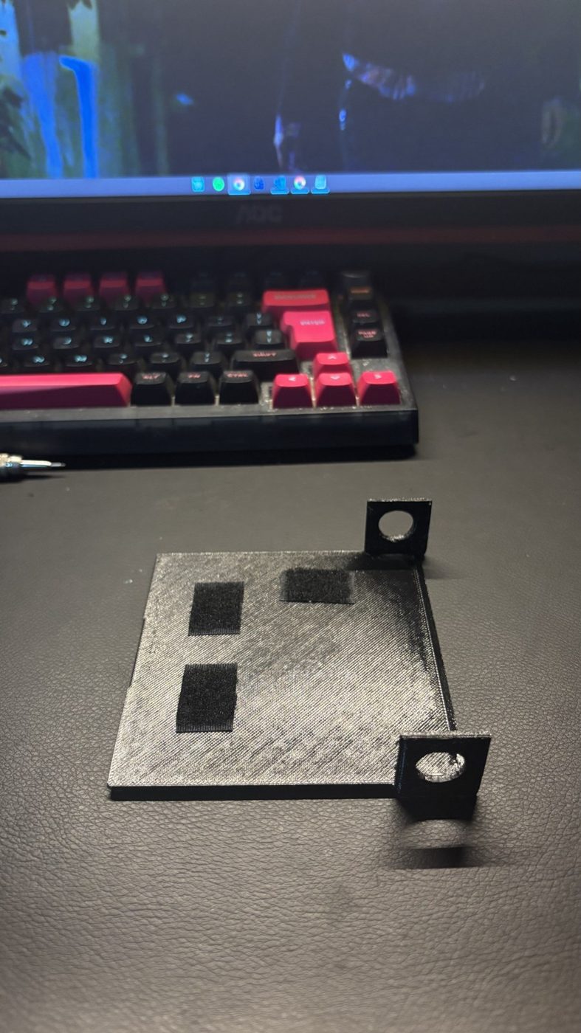
hardware/fotos/caixa/base-vista-em-angulo.jpg
