enzopereira1701/wineguard/hardware/fotos/caixa/tampa.jpg

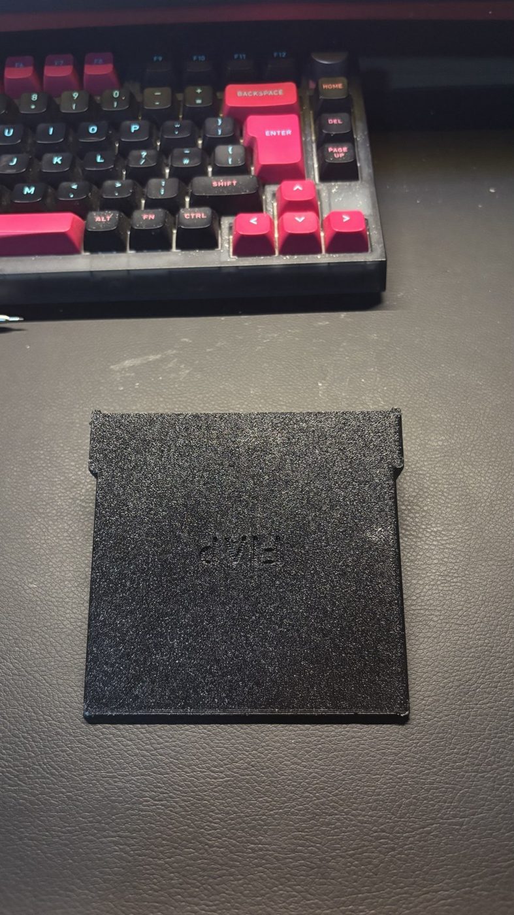
hardware/fotos/caixa/tampa.jpg
