enzopereira1701/wineguard/hardware/fotos/node/alerta-led-vermelho.jpg

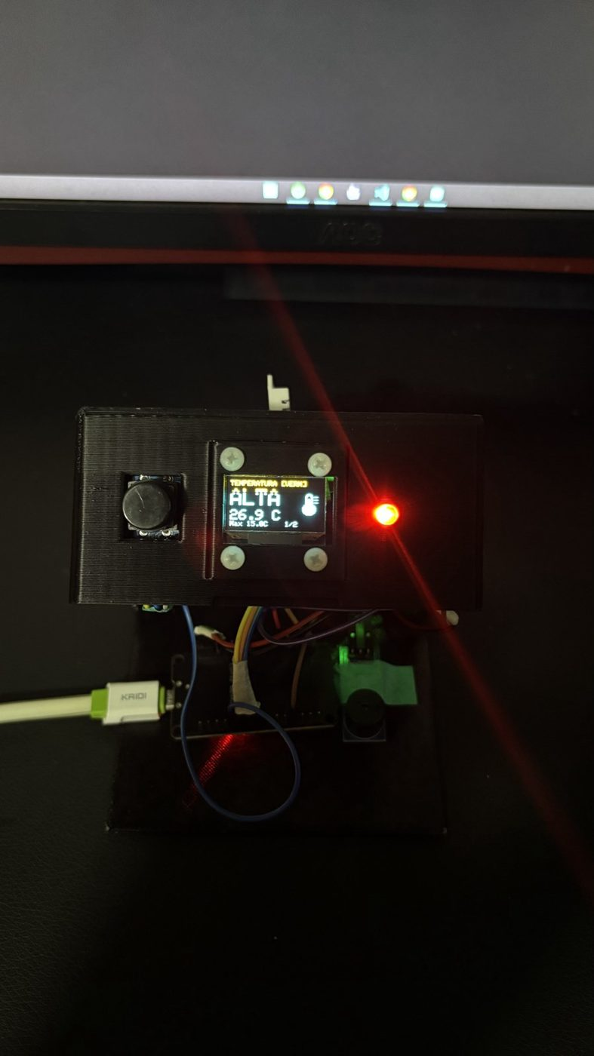
hardware/fotos/node/alerta-led-vermelho.jpg
