enzopereira1701/wineguard/hardware/fotos/node/alerta-luz-alta.jpg

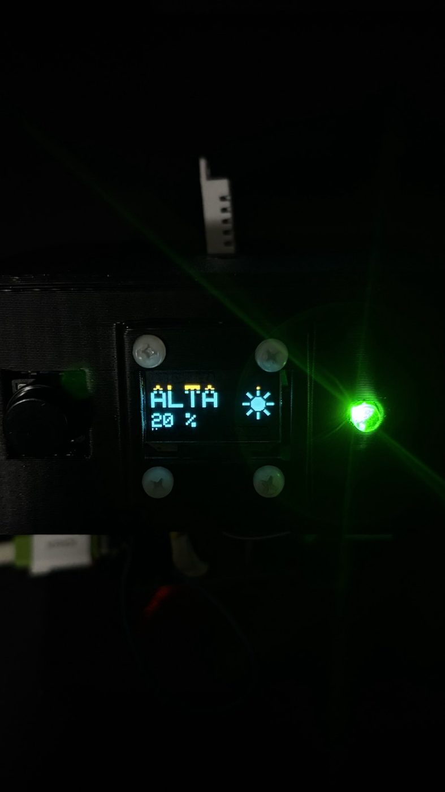
hardware/fotos/node/alerta-luz-alta.jpg
