enzopereira1701/wineguard/hardware/fotos/node/alerta-luz-escuro.jpg

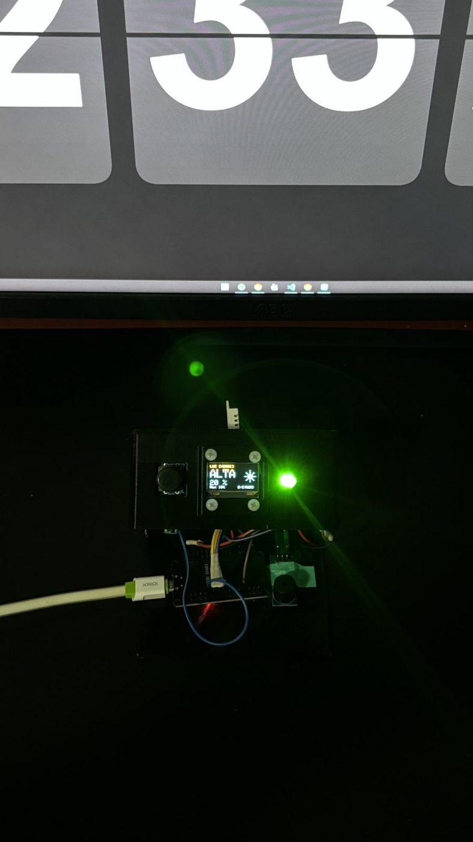
hardware/fotos/node/alerta-luz-escuro.jpg
