enzopereira1701/wineguard/hardware/fotos/node/alerta-luz-oled.jpg

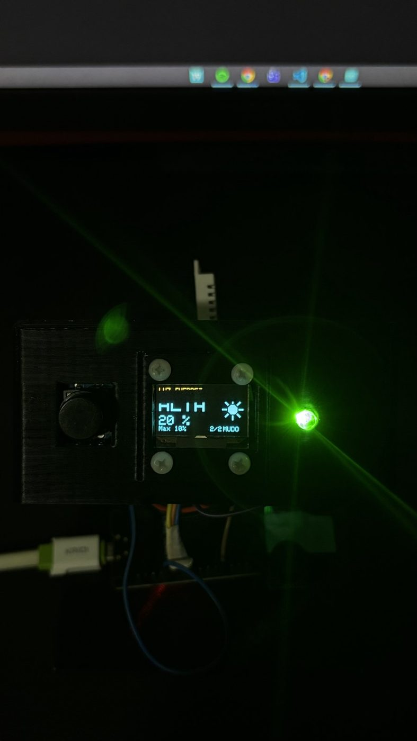
hardware/fotos/node/alerta-luz-oled.jpg
