enzopereira1701/wineguard/hardware/fotos/node/montado-diagonal.jpg

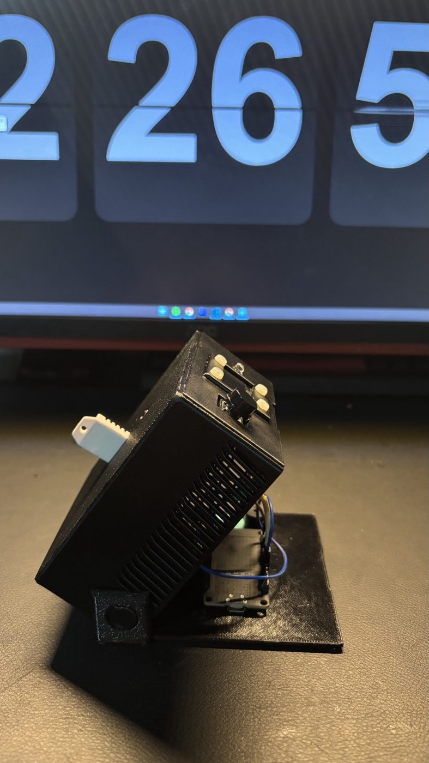
hardware/fotos/node/montado-diagonal.jpg
