enzopereira1701/wineguard/hardware/fotos/node/montado-lateral.jpg

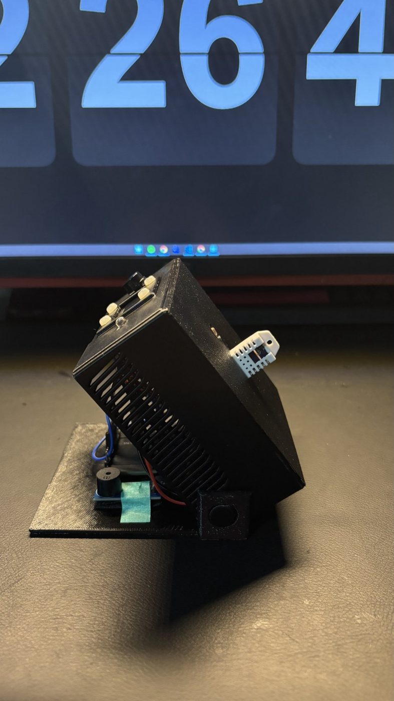
hardware/fotos/node/montado-lateral.jpg
