enzopereira1701/wineguard/hardware/fotos/node/montado-traseira.jpg

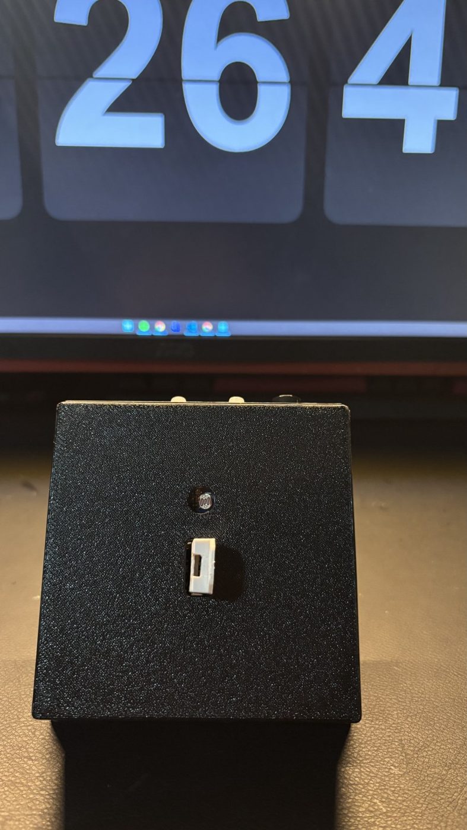
hardware/fotos/node/montado-traseira.jpg
