enzopereira1701/wineguard/hardware/fotos/componentes/buzzer.jpg

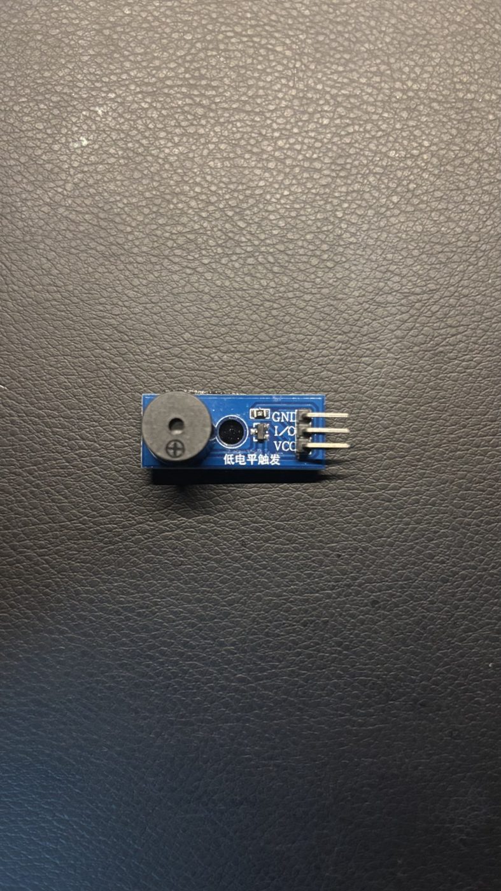
hardware/fotos/componentes/buzzer.jpg
