enzopereira1701/wineguard/hardware/fotos/componentes/dht22.jpg

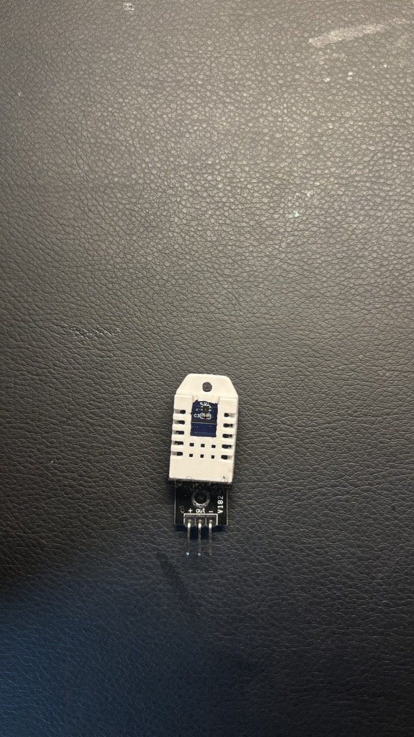
hardware/fotos/componentes/dht22.jpg
