enzopereira1701/wineguard/hardware/fotos/componentes/esp32-devkit.jpg

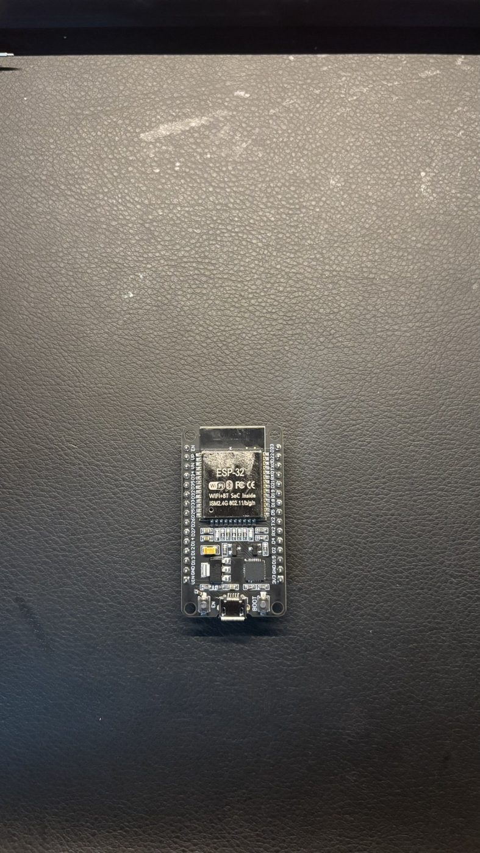
hardware/fotos/componentes/esp32-devkit.jpg
