enzopereira1701/wineguard/hardware/fotos/componentes/ldr-sensor-de-luz.jpg

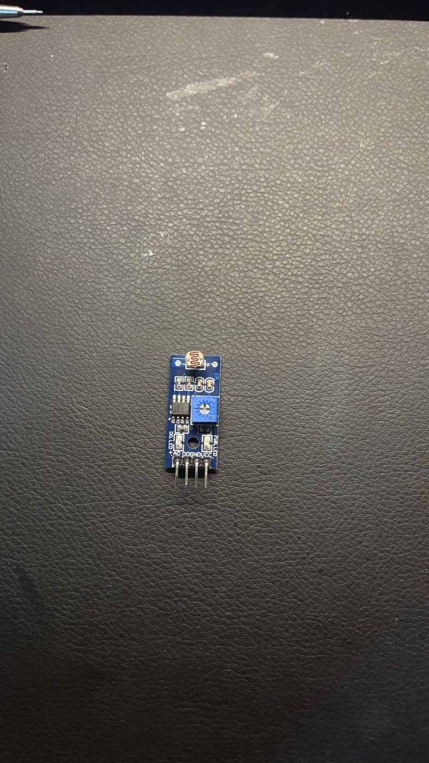
hardware/fotos/componentes/ldr-sensor-de-luz.jpg
