enzopereira1701/wineguard/hardware/fotos/componentes/led-rgb.jpg

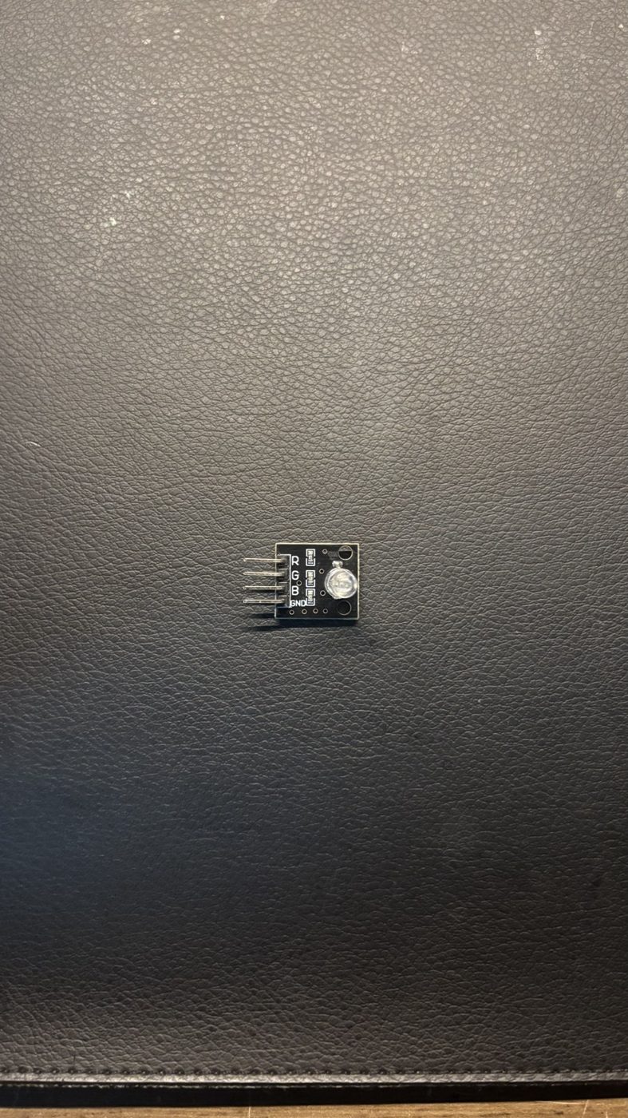
hardware/fotos/componentes/led-rgb.jpg
