enzopereira1701/wineguard/hardware/fotos/componentes/oled.jpg

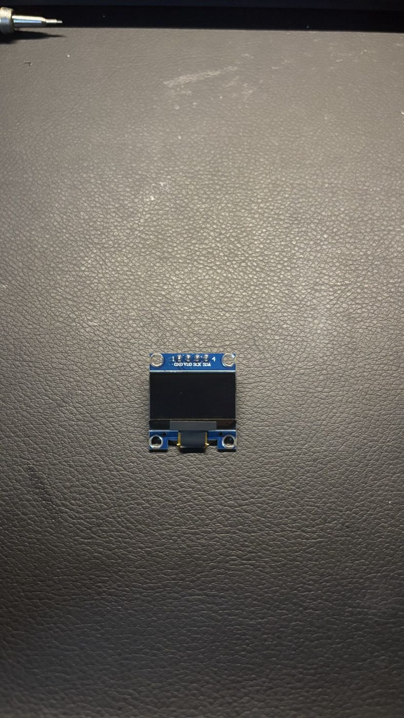
hardware/fotos/componentes/oled.jpg
