enzopereira1701/wineguard/hardware/fotos/componentes/protoboard.jpg

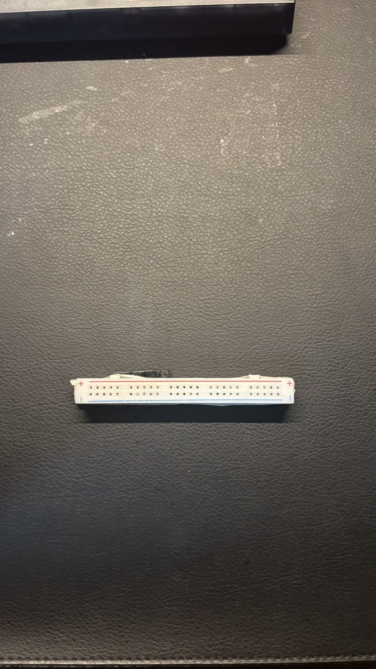
hardware/fotos/componentes/protoboard.jpg
