enzopereira1701/wineguard/docs/prints/triggers_2.png

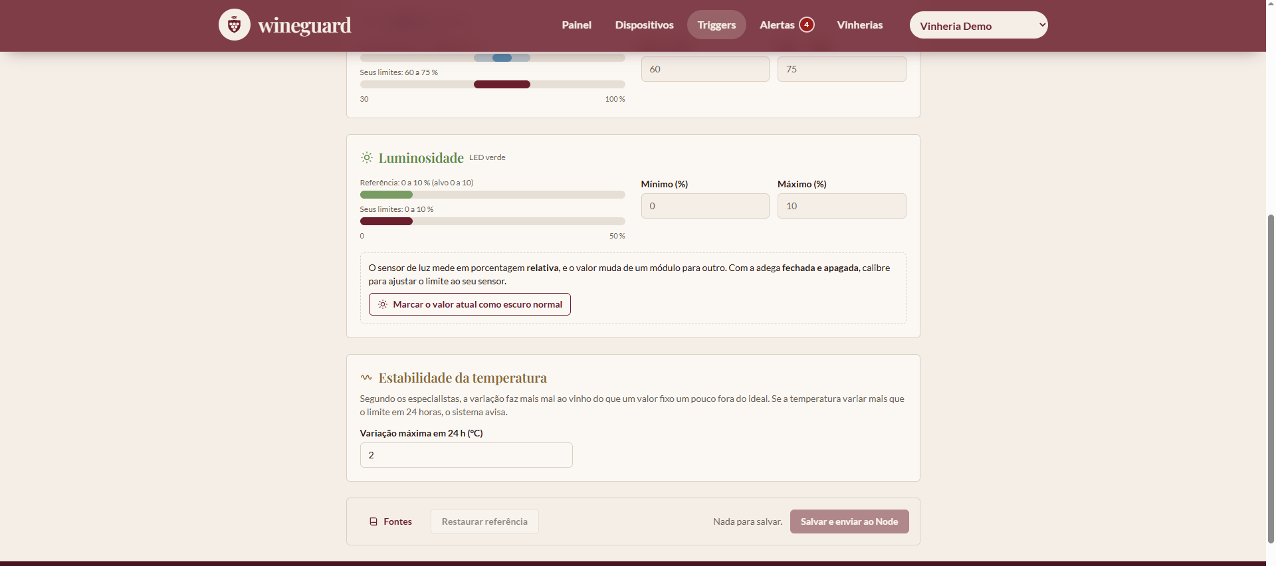
docs/prints/triggers_2.png
