enzopereira1701/wineguard/hardware/firmware/wineguard_node/icones.h

#pragma once
#include <Arduino.h>
// Icones 32x32, 1 bit. Uso: display.drawBitmap(x, y, ICO_TEMP, 32, 32, SSD1306_WHITE);
#define ICO_W 32
#define ICO_H 32

const unsigned char ICO_TEMP[] PROGMEM = {
  0x00, 0x00, 0x00, 0x00, 0x00, 0x00, 0x00, 0x00,
  0x00, 0x03, 0xC0, 0x00, 0x00, 0x0F, 0xF0, 0x00,
  0x00, 0x0E, 0x70, 0x00, 0x00, 0x1C, 0x38, 0x00,
  0x00, 0x18, 0x19, 0xF0, 0x00, 0x18, 0x18, 0x00,
  0x00, 0x18, 0x18, 0x00, 0x00, 0x19, 0x98, 0x00,
  0x00, 0x1B, 0xD9, 0xF0, 0x00, 0x1B, 0xD8, 0x00,
  0x00, 0x1B, 0xD8, 0x00, 0x00, 0x1B, 0xD8, 0x00,
  0x00, 0x1B, 0xD9, 0xF0, 0x00, 0x1B, 0xD8, 0x00,
  0x00, 0x1F, 0xF8, 0x00, 0x00, 0x1F, 0xF8, 0x00,
  0x00, 0x7F, 0xFE, 0x00, 0x00, 0x7F, 0xFF, 0x00,
  0x00, 0xFB, 0xDF, 0x00, 0x01, 0xF7, 0xEF, 0x80,
  0x01, 0xEF, 0xF7, 0x80, 0x01, 0xEF, 0xF7, 0x80,
  0x01, 0xCF, 0xFB, 0x80, 0x01, 0xEF, 0xF3, 0x80,
  0x01, 0xEF, 0xF7, 0x80, 0x00, 0xE7, 0xE7, 0x00,
  0x00, 0xF3, 0xCF, 0x00, 0x00, 0x7C, 0x3E, 0x00,
  0x00, 0x1F, 0xF8, 0x00, 0x00, 0x0F, 0xF0, 0x00
};

const unsigned char ICO_UMID[] PROGMEM = {
  0x00, 0x00, 0x00, 0x00, 0x00, 0x00, 0x00, 0x00,
  0x00, 0x01, 0x80, 0x00, 0x00, 0x03, 0xC0, 0x00,
  0x00, 0x07, 0xE0, 0x00, 0x00, 0x07, 0xE0, 0x00,
  0x00, 0x0E, 0x70, 0x00, 0x00, 0x1E, 0x78, 0x00,
  0x00, 0x1C, 0x38, 0x00, 0x00, 0x38, 0x1C, 0x00,
  0x00, 0x78, 0x1E, 0x00, 0x00, 0xF0, 0x0F, 0x00,
  0x00, 0xE0, 0x07, 0x00, 0x01, 0xE0, 0x07, 0x80,
  0x03, 0xC0, 0x03, 0xC0, 0x03, 0x80, 0x01, 0xC0,
  0x03, 0x80, 0x01, 0xE0, 0x07, 0x00, 0x00, 0xE0,
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
  0x3F, 0xFF, 0xF8, 0xFF, 0xFF, 0xE0, 0x1F, 0xFF, 0xE0, 0x3F, 0xFF, 0xC0,
  0x1F, 0xFF, 0xC0, 0x1F, 0xFF, 0xC0, 0x0F, 0xFF, 0xC0, 0x1F, 0xFF, 0x80,
  0x07, 0xFF, 0x80, 0x0F, 0xFF, 0x00, 0x07, 0xFF, 0x80, 0x0F, 0xFF, 0x00,
  0x03, 0xFF, 0x80, 0x0F, 0xFE, 0x00, 0x01, 0xFF, 0xC0, 0x1F, 0xFC, 0x00,
  0x00, 0xFF, 0xC0, 0x1F, 0xF8, 0x00, 0x00, 0x7F, 0xE0, 0x3F, 0xF0, 0x00,
  0x00, 0x1F, 0xF0, 0x7F, 0xC0, 0x00, 0x00, 0x0F, 0xFF, 0xFF, 0x80, 0x00,
  0x00, 0x07, 0xFF, 0xFF, 0x00, 0x00, 0x00, 0x01, 0xFF, 0xFC, 0x00, 0x00,
  0x00, 0x00, 0xFF, 0xF8, 0x00, 0x00, 0x00, 0x00, 0x3F, 0xE0, 0x00, 0x00,
  0x00, 0x00, 0x0F, 0x80, 0x00, 0x00, 0x00, 0x00, 0x02, 0x00, 0x00, 0x00
};
