enzopereira1701/wineguard/(commit log)

2026-10-04 feat: script de provisionamento do FIWARE
2026-10-07 docs: README completo, arquitetura, esquema de ligação, decisões e firmware 2.3
2026-10-08 Backend 2: cadastro de dispositivos no IoT Agent com apikey, resumo e remocao
    - POST/GET /api/vinherias/{id}/dispositivos, PATCH/DELETE /api/dispositivos/{id}, GET /api/vinherias/{id}/resumo
    - contador global de ids (wgn002, wgn003...) que nunca reaproveita
    - assinatura do STH com TimeInstant na condicao: historico continuo
    - rotas por dispositivo descobrem a adega pelo atributo adegaId
    - testes do cadastro contra um FIWARE falso (60 testes)
2026-10-08 Reconciliacao so vale se o Node publicou depois do ultimo comando (evita reenvio com Node lento)
    - precisa_reconciliar recebe a hora da ultima leitura
    - novos testes (119 no total)
    - silencia o log de pedidos do httpx
2026-10-16 feat(frontend): dashboard React + Vite com camada de API
2026-10-16 docs: prints do dashboard com o Node real
2026-10-16 docs: decisoes atualizado (cronograma e aprendizados de 16/10)
2026-10-27 docs: READMEs de backend, frontend e firmware atualizados
2026-10-27 docs: diagrama de arquitetura atualizado (sem Vercel e HTTPS)
2026-10-27 docs: manuais de instalação e de operação
    Claude-Session: https://claude.ai/code/session_01FMcUBwbYctRkE58xVjGBCY
2026-10-29 docs: link do vídeo de demonstração
